rafaelchiafarelli/ArduinoIHM/IHM/initiatives/rs485_modbus/epics/uart3_driver/README.md

# Epic: uart3_driver

Interrupt-driven USART3 for RS-485 half-duplex.

## Tasks

```
1-usart3-rings-and-direction   RX ISR -> frame buffer + silence-timer re-arm, UDRE TX, TXC DE/RE release   (deps: can_bus event_timer/1; blocked: Q1, Q7)
```

## Acceptance gate

Build + native suite (ring tests); bench: loopback through the RS-485
module at 9600 and 115200 baud, with no lost bytes and the DE line
released within one character time after the last stop bit (scope).
