rafaelchiafarelli/ArduinoIHM/IHM/demo/HARDWARE_RUNBOOK.md

# Hardware runbook: PWM subsystem

Companion to `demo/demo_pwm_walkthrough.cpp`. That program proves the PWM
register math is correct by running the real production code against fake
registers on a PC. This runbook is the same checks, but on the real board,
where a bad COM-bit or a clobbered register would actually show up on a
scope/LED/motor instead of in a printed hex byte.

Requires: Arduino Mega 2560 flashed with this firmware, the display/rotary
encoder hardware wired per the schematic, and (for the PWM checks) an
oscilloscope or logic analyzer on the relevant pin -- a multimeter can
confirm duty cycle roughly via average DC voltage but won't show frequency
or edge polarity.

## Pin reference

| Channel | Timer  | Pin(s) | Notes |
|---|---|---|---|
| 0 | Timer3 | OC3A | simplex |
| 1 | Timer5 | OC5A | simplex -- OC5B/OC5C are claimed by the rotary encoders (PL4/PL5), so only OC5A is free |
| 2 | Timer1 | OC1A / OC1B / OC1C | complex, 3 outputs |
| 3 | Timer4 | OC4A / OC4B / OC4C | complex, 3 outputs |

Check your board variant's pinout diagram (`ELEC-MEGA2560-PINOUT.webp` in
the repo root) for which physical header pin each OCnX maps to.

## Driving PWM over MAVLink

The board accepts `PWM_CHANNEL_CONFIG` (id 303) on its protocol serial port,
Serial2 (D16/D17 through a USB-TTL adapter, 250000 baud, the same port as the
telemetry). The board's own USB port is debug-only. `COMx` below is the
adapter's port. Two ways to send it:

- **Companion app** (`IHMPCController`, PWM panel) -- see its `HOW_TO_USE.md`.
- **Script**: `python mavlink/scripts/pwm_config.py` (needs `pip install pymavlink`).

Prerequisites: board flashed with this firmware, USB-TTL adapter on Serial2,
nothing else holding the port (close the companion before using the script).

Duty is given in **percent** on the wire; the board scales it to the timer's
resolution. Frames with a bad channel (>3) or frequency selector are
silently dropped -- there is no ack, so probe the pin to confirm.

**Example A -- simplex channel 0 (OC3A), 62.5 kHz, 25 % duty**

    python mavlink/scripts/pwm_config.py --port COMx --channel 0 --freq 62500_HZ --a on --a-duty 25

Probe OC3A: 62.5 kHz square wave, 25 % high.

**Example B -- complex channel 2 (OC1A/OC1B), two outputs, different duties**

    python mavlink/scripts/pwm_config.py --port COMx --channel 2 --freq 3906_HZ --a on --a-duty 20 --b on --b-invert --b-duty 60

Probe OC1A (20 % high) and OC1B (inverting: 60 % duty means 40 % high) on a
shared 3.9 kHz timebase; OC1C stays disconnected.

See "Pin reference" above for the pins. This drives the same registers as
the on-screen PWM tab, so the two fight over a channel -- last writer wins,
the PWM tab mirrors PC-driven changes (enable, duty, state label showing the
frequency; complex channels' per-output *inverting* is not shown -- the UI has
no field for it) and repaints only while that tab is showing.

## UI navigation (src/main.cpp, lib/GUI/pwm.screen.yaml)

1. Power on. Rotate rot0 (encoder 0) to switch tabs (PWM / SERIAL / Output).
2. Rotate rot1 (encoder 1) to move the focus ring through the tab's
   controls: on the PWM tab, each channel's frequency label, its
   Enabled/Inverting (CH0/CH1) or A/B/C enable (CH2/CH3) switches, and every
   duty bar. The ring surrounds exactly the control rot2 will change.
3. Press rot1's button to activate the focused control: a switch flips; a
   frequency label steps to the next lower frequency (15 Hz wraps to
   62500 Hz); a duty bar does nothing.
4. Rotate rot2 (encoder 2) to change whatever is focused, live, with no
   confirm step:
   - frequency label: CW = higher, CCW = lower, stopping at 62500 Hz and
     15 Hz. Only the 13 fixed frequencies; VARIABLE (raw TOP) is PC-only.
   - duty bar: 1 % per detent, CW = higher, stopping at 0 and 100 %.
   - switch (PWM Enabled/Inverting, relay on the Output tab): CW = on /
     inverting, CCW = off / non-inverting. It sets, never flips: turning
     further the same way does nothing.

## Checks

### 1. Every fixed frequency actually appears (channels 0 and 1)

For channel 0 (or 1): cycle Mode to Fixed, then step Frequency through all
13 fixed entries. At each step, probe OC3A (or OC5A) and confirm the scope
shows the frequency printed in the demo log / on screen (e.g. `F:62500Hz`).
Pay particular attention to the 9-bit and 10-bit entries (frequencies
31250Hz, 15625Hz, 3906Hz, 1953Hz, 488Hz, 244Hz, 122Hz, 61Hz, 30Hz, 15Hz) --
these are exactly the cases where the pre-fix firmware produced no output
at all (missing COMnX1). If any of these show nothing on the scope, that's
a regression of the branch 2 fix.

### 2. Edge polarity (rising vs falling)

At any fixed frequency with duty cycle set away from 50% (so rising/falling
look visibly different), toggle the Edge field and confirm the scope shows
the duty-high portion moving from the start of the period (rising/
non-inverting) to the end (falling/inverting).

### 3. Duty cycle sweep

Step Duty Cycle from 0% to 100% and confirm the scope's measured duty cycle
tracks it. Check at least one 8-bit frequency (e.g. 62500Hz), one 9-bit
(31250Hz), one 10-bit (15625Hz), and Variable mode -- these each scale the
0-100% UI value against a different raw TOP (255/511/1023/your chosen
Variable Top), per `pwmResolutionTop()`.

### 4. Variable frequency mode

Cycle Mode to Variable, then adjust the Frequency field (now the raw TOP
register instead of a fixed-frequency list -- see the on-screen Hz readout,
computed as `16MHz / (TOP+1)`). Confirm the scope frequency matches the
on-screen readout at a couple of different TOP values.

### 5. Complex channel independence (channels 2 and 3)

With channel 2 (or 3) selected: enable output A at some duty cycle, probe
OC1A. Then, *without touching A's fields again*, enable output B at a
different duty cycle and inverted edge, and re-probe OC1A -- it must be
unchanged. Then enable output C and re-probe both OC1A and OC1B -- both
unchanged. This is the same sequence `runComplexIndependenceProof()` runs
against fake registers in the demo; on hardware it's the same proof against
a scope instead of a printed byte.

### 6. Mode field / Off state

For a simplex channel, cycle Mode to Off and confirm the pin goes idle
(steady low, no toggling) -- this is the case that used to have no explicit
"disabled" concept at all (see PWMChannelConfig's 3-way mode cycle).

## Out of scope for this pass

The relay outputs (`lib/MultiOutput/src/Relay.*`) and the serial command
protocol
(`lib/Comms/src/SerialCommunication.*`) are **not** exercised by this demo
or wired into the UI -- exactly as found in the original review, and
unchanged by any of the 5 branches in this pass (their scope was PWM
configuration, encoder/button input, and the Timer2 ISR setup only).
`MultiOutput::slow_handler()` runs from the tick already, but nothing
ever calls `Relay::enableRelay()` or feeds bytes into
`SerialCommunication::receive()`. (Servo and DC/stepper motor output were
items here originally -- `ServoMotor` was deleted 2026-08-16 and
`MotorDC` 2026-09-28, `fixes/000013`; neither is part of the IHM
solution now.) Wiring those into the UI (and, for serial,
fixing the unbounded `rcv_counter` growth in `receive()` noted in the
original review) is natural follow-up work, but doing it here would mean
demoing code nobody asked to have fixed yet.
