rafaelchiafarelli/ArduinoIHM/IHM/initiatives/rs485_modbus/epics/slave_register_map/tasks/3-bus-config-regs.md

# Task 3: bus-config-regs

**Status:** planned -- blocked on open question 6 (commit rule)
**Depends on:** task 2, `rs485_modes/1` (RS-485 settings), `serial_config`'s `config_model/1`

## Contract

1. The `SerialConfig` fields as holding registers: the generator fields
   (`serial_config`), the RS-485 settings (`rs485_modes/1`), and any CAN
   bus/protocol settings that exist by then (added by `can_bus`), each
   using its owner's validation.
2. The commit rule from open question 6, so a Modbus master can't cut
   its own link by accident.
3. Changes persist per `serial_config`'s save policy.
