rafaelchiafarelli/ArduinoIHM/IHM/initiatives/can_bus/epics/main_loop_timing/tasks/1-bound-the-loop.md

# Task 1: bound-the-loop

**Status:** planned (optional -- open question 4 answered: protocols are ISR-driven)
**Depends on:** nothing

## Contract

1. `app.yaml`
   `display.render_mode: non_blocking`, `main.cpp` calls
   `janus_render_poll()` each pass and uses the `*_async_start` calls;
   regen `lib/GUI` and re-vendor the companion.
2. Measure and record the worst-case loop period before and after.
3. Side effect to check: `IHM_UI_STATE` (308) no longer pauses during
   screen switches (the 1.97 s gap seen on 2026-09-27).
