rafaelchiafarelli/ArduinoIHM/IHM/initiatives/can_bus/epics/mcp2515_driver/tasks/3-tx-and-filters.md

# Task 3: tx-and-filters

**Status:** planned
**Depends on:** task 1

## Contract

1. Non-blocking TX through the 3 TX buffers (priority, "buffer full"
   returned, never waited on).
2. Acceptance masks/filters API (standard and extended).
3. Error state: TEC/REC, error-passive and bus-off readable, with
   recovery.
4. Native tests for the filter/mask encoding.
