rafaelchiafarelli/ArduinoIHM/IHM/initiatives/janus_handoff/2026-09-27-row-align-mirror-output.png

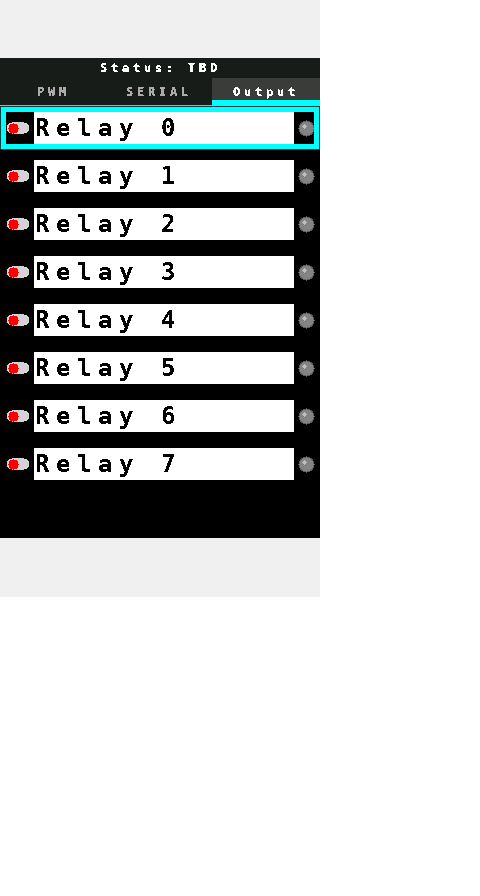
IHM/initiatives/janus_handoff/2026-09-27-row-align-mirror-output.png
