rafaelchiafarelli/ArduinoIHM/IHM/initiatives/janus_handoff/2026-09-27-row-align-mirror-pwm.png

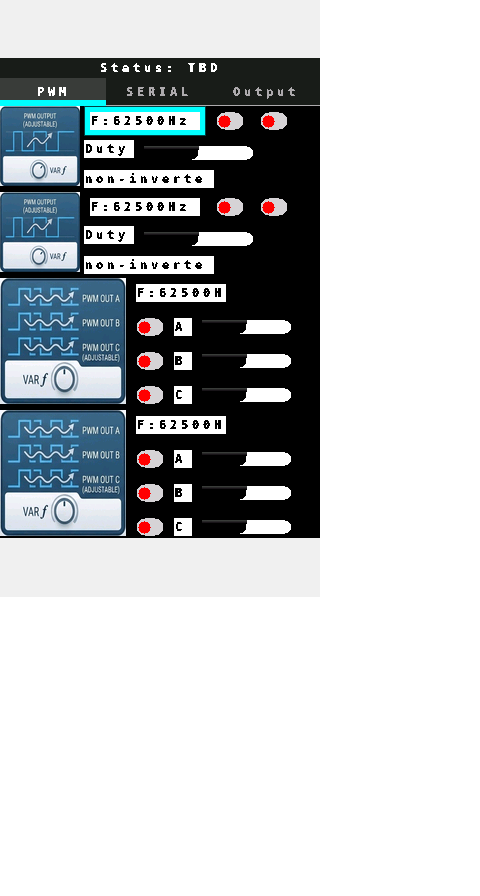
IHM/initiatives/janus_handoff/2026-09-27-row-align-mirror-pwm.png
