rafaelchiafarelli/ArduinoIHM/ElectricalProject/ArduinoIHM.kicad_pcb

## KiCad design ElectricalProject/ArduinoIHM.kicad_pcb (2026-01-17)

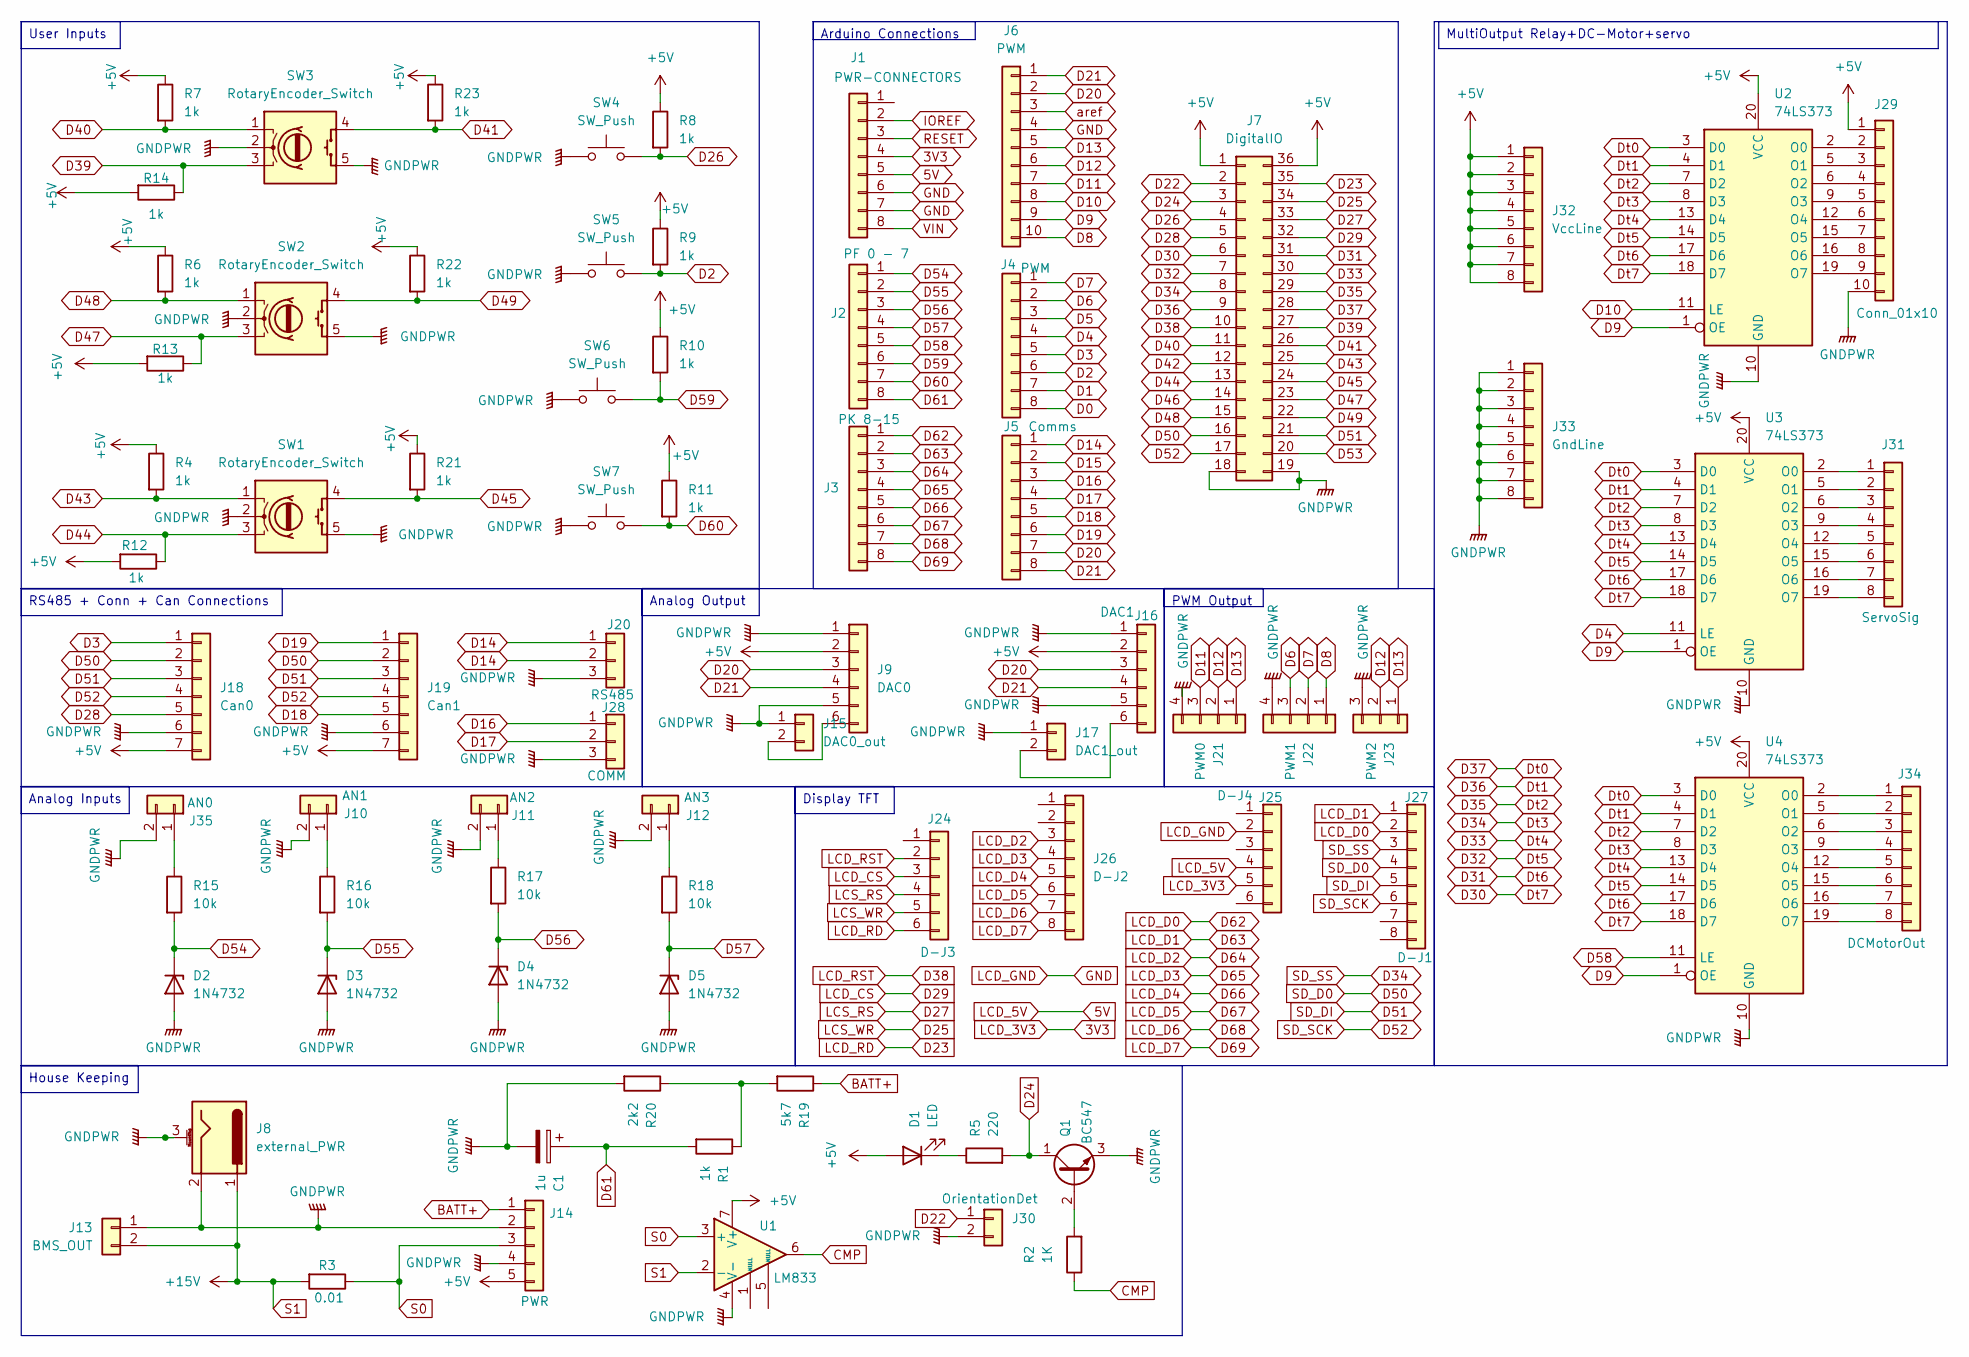
[picture p3: schematic ArduinoIHM.kicad_sch]

Parts:
C1: 1u; electrolytic capacitor
D1: LED; LED_D5.0mm
D2, D3, D4, D5: 1N4732; D_DO-41_SOD81_P10.16mm_Horizontal
J1: PWR-CONNECTORS; PinHeader_1x08_P2.54mm_Vertical
J2: PF 0 - 7; PinHeader_1x08_P2.54mm_Vertical
J3: PK 8-15; PinHeader_1x08_P2.54mm_Vertical
J4: PWM; PinHeader_1x08_P2.54mm_Vertical
J5: Comms; PinHeader_1x08_P2.54mm_Vertical
J6: PWM; PinHeader_1x10_P2.54mm_Vertical
J7: DigitalIO; PinHeader_2x18_P2.54mm_Vertical
J8: external_PWR; FanPinHeader_1x03_P2.54mm_Vertical
J9: DAC0; PinHeader_1x06_P2.54mm_Vertical
J10: AN1; PinHeader_1x02_P2.54mm_Vertical
J11: AN2; PinHeader_1x02_P2.54mm_Vertical
J12: AN3; PinHeader_1x02_P2.54mm_Vertical
J13: BMS_OUT; PinHeader_1x02_P2.54mm_Vertical
J14: PWR; PinHeader_1x05_P2.54mm_Vertical
J15: DAC0_out; PinHeader_1x02_P2.54mm_Vertical
J16: DAC1; PinHeader_1x06_P2.54mm_Vertical
J17: DAC1_out; PinHeader_1x02_P2.54mm_Vertical
J18: Can0; PinHeader_1x07_P2.54mm_Vertical
J19: Can1; PinHeader_1x07_P2.54mm_Vertical
J20: RS485; PinHeader_1x03_P2.54mm_Vertical
J21: PWM0; PinHeader_1x04_P2.54mm_Vertical
J22: PWM1; PinHeader_1x04_P2.54mm_Vertical
J23: PWM2; PinHeader_1x03_P2.54mm_Vertical
J24: D-J3; PinHeader_1x06_P2.54mm_Vertical
J25: D-J4; PinHeader_1x06_P2.54mm_Vertical
J26: D-J2; PinHeader_1x08_P2.54mm_Vertical
J27: D-J1; PinHeader_1x08_P2.54mm_Vertical
J28: COMM; PinHeader_1x03_P2.54mm_Vertical
J29: Conn_01x10; PinHeader_1x10_P2.54mm_Vertical
J30: OrientationDet; PinHeader_1x02_P2.54mm_Vertical
J31: ServoSig; PinHeader_1x08_P2.54mm_Vertical
J32: VccLine; PinHeader_1x08_P2.54mm_Vertical
J33: GndLine; PinHeader_1x08_P2.54mm_Vertical
J34: DCMotorOut; PinHeader_1x08_P2.54mm_Vertical
J35: AN0; PinHeader_1x02_P2.54mm_Vertical
Q1: BC547; TO-92_Inline
R1, R4, R6, R7, R8, R9, R10, R11, R12, R13, R14, R21, R22, R23: 1k; R_Axial_DIN0207_L6.3mm_D2.5mm_P5.08mm_Vertical
R2: 1K; R_Axial_DIN0207_L6.3mm_D2.5mm_P5.08mm_Vertical
R3: 0.01; R_Axial_DIN0207_L6.3mm_D2.5mm_P5.08mm_Vertical
R5: 220; R_Axial_DIN0207_L6.3mm_D2.5mm_P5.08mm_Vertical
R15, R16, R17, R18: 10k; R_Axial_DIN0207_L6.3mm_D2.5mm_P5.08mm_Vertical
R19: 5k7; R_Axial_DIN0207_L6.3mm_D2.5mm_P5.08mm_Vertical
R20: 2k2; R_Axial_DIN0207_L6.3mm_D2.5mm_P5.08mm_Vertical
SW1, SW2, SW3: RotaryEncoder_Switch; PinHeader_1x05_P2.54mm_Vertical
SW4, SW5, SW6, SW7: SW_Push; SW_PUSH_6mm_H4.3mm
U1: LM833; DIP-8_W7.62mm
U2, U3, U4: 74LS373; DIP-20_W7.62mm

Connections:
3V3: J1.4, J25.5
5V: J1.5, J25.4
+5V: D1.2 (A), J7.1, J7.36, J9.2, J14.5, J16.2, J18.7, J19.7, J29.1, J32.1, J32.2, J32.3, J32.4, J32.5, J32.6, J32.7, J32.8, R4.1, R6.1, R7.1, R8.1, R9.1, R10.1, R11.1, R12.2, R13.2, R14.2, R21.1, R22.1, R23.1, U1.7 (V+), U2.20 (VCC), U3.20 (VCC), U4.20 (VCC)
BATT+: J14.1, R19.1
CMP: R2.1, U1.6
D0: J4.8
D1: J4.7
D2: J4.6, R9.2, SW5.2
D3: J4.5, J18.1
D4: J4.4, U3.11 (LE)
D5: J4.3
D6: J4.2, J22.3
D7: J4.1, J22.2
D8: J6.10, J22.1
D9: J6.9, U2.1 (OE), U3.1 (OE), U4.1 (OE)
D10: J6.8, U2.11 (LE)
D11: J6.7, J21.3
D12: J6.6, J21.2, J23.2
D13: J6.5, J21.1, J23.1
D14: J5.1, J20.1, J20.2
D15: J5.2
D16: J5.3, J28.1
D17: J5.4, J28.2
D18: J5.5, J19.5
D19: J5.6, J19.1
D20: J5.7, J6.2, J9.3, J16.3
D21: J5.8, J6.1, J9.4, J16.4
D22: J7.2, J30.1
D23: J7.35, J24.6
D24: J7.3, Q1.1 (C), R5.2
D25: J7.34, J24.5
D26: J7.4, R8.2, SW4.2
D27: J7.33, J24.4
D28: J7.5, J18.5
D29: J7.32, J24.3
D30: J7.6, U2.18 (D7), U3.18 (D7), U4.18 (D7)
D31: J7.31, U2.17 (D6), U3.17 (D6), U4.17 (D6)
D32: J7.7, U2.14 (D5), U3.14 (D5), U4.14 (D5)
D33: J7.30, U2.13 (D4), U3.13 (D4), U4.13 (D4)
D34: J7.8, J27.3, U2.8 (D3), U3.8 (D3), U4.8 (D3)
D35: J7.29, U2.7 (D2), U3.7 (D2), U4.7 (D2)
D36: J7.9, U2.4 (D1), U3.4 (D1), U4.4 (D1)
D37: J7.28, U2.3 (D0), U3.3 (D0), U4.3 (D0)
D38: J7.10, J24.2
D39: J7.27, R14.1, SW3.3 (B)
D40: J7.11, R7.2, SW3.1 (A)
D41: J7.26, R23.2, SW3.4 (S1)
D42: J7.12
D43: J7.25, R4.2, SW1.1 (A)
D44: J7.13, R12.1, SW1.3 (B)
D45: J7.24, R21.2, SW1.4 (S1)
D46: J7.14
D47: J7.23, R13.1, SW2.3 (B)
D48: J7.15, R6.2, SW2.1 (A)
D49: J7.22, R22.2, SW2.4 (S1)
D50: J7.16, J18.2, J19.2, J27.4
D51: J7.21, J18.3, J19.3, J27.5
D52: J7.17, J18.4, J19.4, J27.6
D53: J7.20
D54: D2.1 (K), J2.1, R15.2
D55: D3.1 (K), J2.2, R16.2
D56: D4.1 (K), J2.3, R17.2
D57: D5.1 (K), J2.4, R18.2
D58: J2.5, U4.11 (LE)
D59: J2.6, R10.2, SW6.2
D60: J2.7, R11.2, SW7.2
D61: C1.1, J2.8, R1.2
D62: J3.1, J27.2
D63: J3.2, J27.1
D64: J3.3, J26.3
D65: J3.4, J26.4
D66: J3.5, J26.5
D67: J3.6, J26.6
D68: J3.7, J26.7
D69: J3.8, J26.8
GND: J1.6, J1.7, J6.4, J25.2
GNDPWR: C1.2, D2.2 (A), D3.2 (A), D4.2 (A), D5.2 (A), J7.18, J7.19, J8.2, J8.3 (MountPin), J9.1, J9.5, J10.2, J11.2, J12.2, J13.1, J14.2, J14.4, J15.1, J16.1, J16.5, J17.1, J18.6, J19.6, J20.3, J21.4, J22.4, J23.3, J28.3, J29.10, J30.2, J33.1, J33.2, J33.3, J33.4, J33.5, J33.6, J33.7, J33.8, J35.2, Q1.3 (E), R20.2, SW1.2 (C), SW1.5 (S2), SW2.2 (C), SW2.5 (S2), SW3.2 (C), SW3.5 (S2), SW4.1, SW5.1, SW6.1, SW7.1, U1.4 (V-), U2.10 (GND), U3.10 (GND), U4.10 (GND)
IOREF: J1.2
unnamed: D1.1 (K), R5.1
unnamed: J10.1, R16.1
unnamed: J11.1, R17.1
unnamed: J12.1, R18.1
unnamed: J9.6, J15.2
unnamed: J16.6, J17.2
unnamed: J29.2, U2.2 (O0)
unnamed: J29.3, U2.5 (O1)
unnamed: J29.4, U2.6 (O2)
unnamed: J29.5, U2.9 (O3)
unnamed: J29.6, U2.12 (O4)
unnamed: J29.7, U2.15 (O5)
unnamed: J29.8, U2.16 (O6)
unnamed: J29.9, U2.19 (O7)
unnamed: J31.1, U3.2 (O0)
unnamed: J31.2, U3.5 (O1)
unnamed: J31.3, U3.6 (O2)
unnamed: J31.4, U3.9 (O3)
unnamed: J31.5, U3.12 (O4)
unnamed: J31.6, U3.15 (O5)
unnamed: J31.7, U3.16 (O6)
unnamed: J31.8, U3.19 (O7)
unnamed: J34.1, U4.2 (O0)
unnamed: J34.2, U4.5 (O1)
unnamed: J34.3, U4.6 (O2)
unnamed: J34.4, U4.9 (O3)
unnamed: J34.5, U4.12 (O4)
unnamed: J34.6, U4.15 (O5)
unnamed: J34.7, U4.16 (O6)
unnamed: J34.8, U4.19 (O7)
unnamed: J35.1, R15.1
unnamed: Q1.2 (B), R2.2
unnamed: R1.1, R19.2, R20.1
RESET: J1.3
S0: J14.3, R3.1, U1.3 (+)
S1: J8.1, J13.2, R3.2, U1.2 (-)
VIN: J1.8
aref: J6.3

Notes on the sheet:
House Keeping
Arduino Connections
Analog Output
RS485 + Conn + Can Connections
Display TFT
Analog Inputs
MultiOutput Relay+DC-Motor+servo
User Inputs
PWM Output

Board: 2 copper layers, 76 parts (0 on the bottom side), 105 nets, no tracks yet.
