rafaelchiafarelli/ArduinoIHM/(commit log)

2025-11-12 moved Arduino library to the project
    [IHMDiagram.kicad_pcb, IHMDiagram.kicad_sch]
2025-11-19 adding files - first assembly
2025-11-30 adding tab configurations to pwm
2025-12-01 fixing pwm module to generate the outputs
2025-12-01 simplex and complex pwm configurations
2025-12-11 electrical project update
    [ArduinoIHM.kicad_sch]
2026-01-17 Electrical project update - fix page size
    [ArduinoIHM.kicad_pcb, ArduinoIHM.kicad_sch, IHMDiagram.kicad_pcb, IHMDiagram.kicad_sch]
2026-08-10 Fix and complete PWMStateMachine; add native unit test harness
    PWMStateMachine.h had a broken #include <events.h (unterminated,
    and events.h doesn't exist anywhere in the repo) and was otherwise
    a plain data-holder with no real transition logic -- it compiled
    only because nothing ever included it.
    - Fix the include, drop it entirely (no dependency was needed).
    - Add real channel selection (selectNextChannel/selectPreviousChannel,
    wrapping across the 4 PWM channels) and field-cursor cycling for
    both the simplex (PWM_0/PWM_1) and complex (PWM_2/PWM_3) channel
    UIs, plus isComplexChannel() so callers can tell which UI applies.
    - Trim SharedPWMStates: drop the D/E/F duty-cycle/edge/activat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
    [main.cpp, mini_test.h, test_pwm_state_machine.cpp]
2026-08-10 Fix PWM register bugs by consolidating into a tested pure core
    PWM.cpp's four setupPWMChannelN() functions were 1109 lines of
    hand-written, heavily copy-pasted register setup (14 frequency cases
    x up to 3 outputs x 4 timers), and every one of the following bugs
    appeared multiple times across that duplication:
    - Missing COMnX1 bit in every 9-bit and 10-bit mode (10 of 14
    frequency cases, in all four channels): the non-inverting branch
    set no COM bits at all (pin stays disconnected), and the inverting
    branch set only COMnX0 -- 0b01, which is a reserved bit combination
    for these Fast PWM widths on the ATmega2560, not "inverting". Both
    branches needed COMnX1 set; only COMnX0 should di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
    [test_pwm_config.cpp, test_pwm_timing.cpp]
2026-08-10 Restore ArduinoIHM.kicad_pcb footprint placement
    This was uncommitted work-in-progress (76 placed footprints) sitting
    in the working tree since around 2026-01-17, never committed. It was
    accidentally discarded by a git reset --hard run while working on an
    unrelated firmware branch; recovered from the KiCad backup zip
    ElectricalProject/ArduinoIHM-backups/ArduinoIHM-2026-01-17_143124.zip
    (still on disk, untracked), which matches the placement state
    observed earlier in the same session.
    No routing yet -- this is placement-only, same as before.
    [ArduinoIHM.kicad_pcb]
2026-08-11 Wire PWMScreen to real PWM hardware, with a live-editable config model
    Every value setupPWMChannelN() takes was previously either hardcoded
    or never called at all: PWMSimplex/PWMComplex only ever showed static
    placeholder text ("---%", "f:----------Hz", ...), and PWM pwm; in
    main.cpp was an unused object. There was no data model for "what is
    this channel currently configured to do" anywhere in the firmware.
    - PWMChannelConfig / PWMComplexChannelConfig (new): the UI-editable
    state for a channel -- enabled, frequency, duty cycle, edge -- plus
    pure mutation methods (cycle frequency, adjust duty %, toggle edge)
    and computeSimplexCallArgs()/computeComplexCallArgs(), which convert
    that st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
2026-08-11 Fix rot1's encoder/button pin swap; make ISR-shared globals volatile
    Each rotary encoder module occupies 3 consecutive BinaryInputs pin-table
    indices (two quadrature signal pins + one push button) -- encoder0 is
    6/7 with button 8, encoder2 is 12/13 with button 14. Encoder1 broke
    that pattern: RotaryEncoder.h wired its Pin1 to index 11 (PL0, its own
    push button) instead of 10 (PL1, its actual second signal pin), while
    main.cpp's rot1btn extraction read bit 10 instead of bit 11 -- the two
    pins had their roles swapped. Net effect: turning rot1 could look like
    pressing its button and vice versa, and rot1's rotation decode was
    reading its own button state as a quadrature signal.
    - RotaryEncoder.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
    [main.cpp, test_button_map.cpp, test_rotary_encoder.cpp]
2026-08-11 Only enable Timer2's Compare-A interrupt; drop the two empty ISRs
    setup() enabled all three of Timer2's interrupts (OCIE2A, OCIE2B,
    TOIE2) but main.cpp only ever defined a handler for Compare-A
    (TIMER2_COMPA_vect, the system tick). An AVR interrupt that's enabled
    and fires with no ISR defined vectors through avr-libc's default
    handler to __bad_interrupt, which jumps to the reset vector -- so
    Compare-B and Overflow firing here would have silently reset the MCU.
    The two empty ISR(TIMER2_COMPB_vect)/ISR(TIMER2_OVF_vect) definitions
    existed purely to intercept that ("must be defined here otherwise the
    system looses itself", per the comment that was there) rather than
    fixing the actual cause, whi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
    [Timer2Config.h, main.cpp, test_timer2_config.cpp]
2026-08-11 Add PWM outputs demo: host walkthrough + hardware runbook
    demo_pwm_walkthrough.cpp drives the real production code (the same
    PWMChannelConfig/PWMComplexChannelConfig edit methods, computeSimplex-
    CallArgs/computeComplexCallArgs, and applySimplexPWMConfig/
    applyComplexPWMConfig that PWMSimplex::editField/PWMComplex::editField
    call on-device) against fake registers, and prints the resulting
    TCCRxA/TCCRxB/OCRxA/B/C bytes for every channel x frequency x edge
    combination. It's not a pass/fail suite (test_native/ already covers
    that) -- it's a readable log a human can check the fixes against
    directly, e.g.:
    F:31250Hz edge=falling -> TCCRxA=0xC2 (9-bit inverting: both COM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
    [demo_pwm_walkthrough.cpp]
2026-08-11 Add changelog documenting today's PWM subsystem work
    Summarizes the branch stack (fix/pwm-state-machine through
    fix/timer2-isr-cleanup), the independent kicad_pcb restore branch, and
    this demo branch: what each fixes, test counts, and what's still out
    of scope. Meant to be read alongside the branches themselves when
    reviewing/merging the stack.
2026-08-12 Note Display-glue testing scope in handoff notes
    Investigated item 2 from the last handoff (native tests for PWM's
    Display-facing glue) before starting it. Element holds a concrete
    Display*, and Display/GFX.h chain into avr/io.h the same way
    SerialCommunication.h did -- testing it natively needs either a full
    Arduino/Display compatibility shim or a production-code interface
    refactor, not a quick test file. Recording that so it isn't
    re-discovered from scratch next time.
2026-08-12 Kill Display-glue native-test follow-up (won't fix)
    Decided not to pursue native tests for PWMSimplex/PWMComplex/GUI.cpp's
    Display-facing glue: the plan is to switch to an SPI display next
    hardware revision, which replaces the current parallel-TFT driver
    outright. Any test investment in today's Display/GFX glue would be
    thrown away, so it's not worth the compatibility-shim or
    interface-refactor effort scoped out on 2026-08-11.
2026-08-12 Wire Relay outputs into the UI (Output tab)
    First of the three not-wired-in output types (relay/servo/motor) from
    the 2026-08-10 follow-ups -- scoped to Relay only. Follows the same
    pattern already proven for PWM: a pure/testable RelayConfig, thin
    Display-facing RelayElement/RelayScreen glue, then GUI wiring. rot1
    rotates through the 8 relays on the Output tab, its button toggles
    the highlighted one live.
    Confirmed pin safety first: Relay uses BinaryOutputs indices 0-7
    exclusively, no overlap with MotorDC (8-13) or ServoMotor (8-17) --
    those two overlap each other, a pre-existing issue left untouched.
    MultiOutput now exposes getRelays() so GUI drives the same Relay
    instance MultiOutput::slo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
    [main.cpp, test_relay_config.cpp]
2026-08-12 Add architecture documentation; discover multiplexed output bus
    Full documentation pass: ARCHITECTURE.md, a README in every lib/ module
    and src/, and a drawio diagram covering the module map, scheduling
    model, and known gaps.
    While investigating a suspected Timer4 register conflict between PWM
    channel 3 and a planned ServoMotor wiring, cross-checking against the
    user's IOs IHM.xlsx and KiCad schematic revealed that Relay/ServoMotor/
    MotorDC don't drive independent GPIO pins at all -- they share one 8-bit
    bus behind three 74LS373 latches, addressed by per-device strobe lines
    (dig_0/dig_1/dig_2). BinaryOutputs::SetOutput() doesn't implement this
    protocol, so Relay's existing UI wiring likely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
    [ArduinoIHM.kicad_sch, IOs IHM.xlsx]
2026-08-12 Sync IOs IHM.xlsx (v0) pin plan with ArduinoIHM.kicad_sch
    Relabeled global_label pin numbers across the encoder/output-bus
    region to match the "v0" sheet's new plan, and fixed a leftover
    LCD_RST label that was still on D38 (shorted against rotary
    encoder 2's channel-A switch) instead of its new D31 assignment.
    Note: this is the last commit before the IO change.
    [ArduinoIHM.kicad_sch, IOs IHM.xlsx]
2026-08-12 Add MAVLink telemetry/command protocol and analog-input driver
    New IHM_BOARD_STATE/CAN_SIGNAL_CONFIG/RS485_SIGNAL_CONFIG dialect
    (IHM/mavlink/), wired into main.cpp's superloop: board pushes user-input +
    analog telemetry roughly every 100ms, and parses incoming CAN/RS-485
    signal-generator commands (stored only -- no bus driver exists yet to act
    on them). Replaces the redundant raw Serial.print() debug lines, which
    would otherwise have corrupted the binary MAVLink stream on the same UART.
    Also new: a register-direct ADC driver (lib/AnalogInput) for the 4 analog
    inputs + BattVoltage, none of which were read anywhere in this codebase
    before. Flagged as a known gap (ARCHITECTURE.md item 9): it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
    [main.cpp]
2026-08-14 Write the multiplexed-output-bus driver; fix Relay's write sequence
    MultiplexedBus (lib/MultiOutput/src/MultiplexedBus.h) implements the
    settle-bus -> raise-strobe -> drop-strobe protocol Relay/ServoMotor/
    MotorDC's three 74LS373 latches need, on top of BinaryOutputs::SetOutput(),
    wrapped in ATOMIC_BLOCK so ServoMotor's future ISR-context writes can't
    race Relay/MotorDC's foreground writes. enableOutputs() drives OUTPUT_EN
    low once at setup, confirmed active-low against the KiCad schematic.
    Relay rewired to use it (assembles all 8 relays into one byte, one
    write() call) instead of the old one-SetOutput()-per-relay model.
    ServoMotor/MotorDC untouched -- still blocked on their own bit-layout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
2026-08-14 Ignore committed backup zips going forward
    ElectricalProject/ArduinoIHM-backups/*.zip was being tracked by
    accident; a git filter-repo history rewrite already stripped the 18
    existing zips out of dev's history in this session. This just stops
    new ones from getting added the same way.
2026-08-14 Delete confirmed-dead code: StateMachine, SPITFT/GrayOLED, Stream's timeout methods
    Cleared out dead code found while writing the multiplexed-bus driver and
    while investigating a while(millis()) loop the user flagged in Stream.cpp.
    - lib/StateMachine/StateMachine.hpp/.cpp: didn't compile, unreferenced.
    PWMStateMachine.h (actually used) is untouched.
    - lib/Display/SPITFT.cpp/.h, SPITFT_Macros.h, GrayOLED.cpp/.h: vendored,
    confirmed nothing else included them.
    - Stream's millis()-based timeout/parsing methods (timedRead, readBytes,
    parseInt, find, etc.): zero callers outside ArduinoLib, confirmed by
    grep before deleting. Stream.h now only declares the pure-virtual
    available()/read()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
    [main.cpp]
2026-08-14 Note: connected board is an old hw revision, flash doesn't mean verified
    Uploaded this session's firmware (with the new MultiplexedBus driver) to
    a Mega 2560 clone on COM7 -- upload succeeded and verified, but the user
    confirmed the physical hardware connected is an old revision, not the
    board the multiplexed-bus/74LS373-latch model was derived from. A
    successful flash isn't the same as a hardware test; the "unverified
    against a physical board" caveat throughout the docs still stands.
2026-08-15 Simplify the on-board TFT UI; build a real SERIAL/bus-status screen
    Element's virtual-by-value setter pattern is gone entirely (grepped: nothing
    ever used polymorphism through it, so de-virtualized rather than just fixed
    the return type), duplicated Label/LED blink-counter logic factored into a
    shared BlinkAnimator (fixing a mis-ordered blink-speed bug along the way),
    magic-number button masks and tab-layout constants named/composed properly,
    and confirmed-dead GUI code (ScreenType/currentWork, six unwired methods)
    deleted.
    The previously-placeholder SERIAL tab is now a real read-only monitor
    (BusStatusScreen) of the CAN0/CAN1/RS-485 signal-generator config the board
    receives from the new P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
    [main.cpp]
2026-08-15 Add UI-rotation planning notes and a current-state render-pipeline diagram
    Portrait/landscape support (housekeeping pin, live switching, non-blocking
    incremental redraw) was scoped in conversation but deliberately not
    designed yet -- ui-rotation.md captures the requirements, constraints, and
    open questions (notably the bit-to-4-angles mapping) for a fresh session to
    pick up. docs/gui-render-pipeline.drawio is a focused diagram of how a
    frame currently gets drawn and where the rotation bit currently goes,
    built to reason about where the new scheduler should plug in -- descriptive
    only, not a proposed design.
2026-08-15 Record UI-rotation scope findings and shelve the feature
    Second-pass assessment found the pin is a pulse (not absolute-position,
    resolving the 4-angle mapping question) but surfaced bigger blockers:
    no edge detection/debounce exists for it yet, the existing MAVLink
    rotation field is already reading it wrong, RAM headroom is tight, and
    widgets hold position as an implicit truth that a live rotation breaks
    (BlinkAnimator erase-by-remembered-rect). Shelved pending those answers.
2026-08-16 Rewrite MotorDC onto the multiplexed bus, wire its tick handler
    MotorDC predated the multiplexed-bus finding and still used raw
    BinaryOutputs indices that collide with PWM's pins and the bus's own
    strobe/OUTPUT_EN lines. Rewritten to go through MultiplexedBus like
    Relay, with coarse software-PWM speed control on the existing ~1ms
    system tick (no dedicated fast timer is free -- Timer1/3/4/5 are fully
    committed to PWM's 4-channel generator). MultiOutput::fast_handler() is
    now actually called from TIMER2_COMPA_vect. Bit layout within MotorDC's
    latched byte is a placeholder pending schematic confirmation.
    [main.cpp]
2026-08-16 Delete ServoMotor: servo control is not part of the IHM solution
    ServoMotor::timer_handler() wrote directly to OCR4A (owned by PWM
    channel 3, actively used) -- same landmine pattern MotorDC had, plus a
    stale pin-index model and a clamp bug. Deeper problem: servos need real
    pulse-width resolution, and like MotorDC there's no dedicated fast timer
    free (Timer1/3/4/5 are fully committed to PWM's 4-channel generator) --
    but unlike MotorDC's coarse on/off duty cycling, servo position control
    can't get away with the existing ~1ms tick's resolution.
    User's call: kill servo support entirely rather than solve that timing
    problem here. A separate, dedicated servo controller is planned for the
    future,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
    [main.cpp]
2026-08-16 Make AnalogInputs::read() non-blocking via an interrupt-driven ADC scan
    read() used to block on a while(ADCSRA & (1<<ADSC)) polling loop --
    ~104-520us across all 5 channels every ~100ms, the same class of problem
    as a delay() call under this project's no-blocking-waits rule.
    AnalogInputs::setup() now starts a free-running round-robin conversion;
    a new ISR(ADC_vect) in main.cpp (calling AnalogInputs::isr_handler())
    caches each completed conversion and immediately triggers the next
    channel, forever. read() just returns the cached value -- non-blocking,
    and fresher than before as a side effect (bounded by one ~1ms scan cycle
    instead of the caller's ~100ms read cadence). Follows the project's
    e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
    [main.cpp]
2026-08-19 Clear content area on tab switch in GUI
    show() only marks elements dirty for the next update() redraw; it never
    clears anything, and no screen's elements cover the full content rect,
    so switching tabs left stale pixels behind. Clear the rect before
    show() on both CCW/CW branches, and drop the switch's unreachable
    default case that used to (wrongly) handle this with a WHITE clear.
2026-08-23 Replace hand-written TFT UI with Janus-generated code; fix AVR PROGMEM bugs
    lib/Elements and the old lib/GUI/GUI.cpp/.h are gone, replaced by UI
    generated by Janus from lib/GUI/*.screen.yaml/app.yaml, plus its
    hand-written runtime (janus_runtime.c/.h, janus_font.*,
    janus_input_focus.*). This migration itself predates this commit; this
    is its first hardware bring-up and first time landing in git.
    First boot hung/rendered garbage due to two AVR PROGMEM bugs in Janus's
    fixed runtime library: janus_app_t.screens is an array of pointers
    living in flash, and every generated janus_screen_desc_t instance is
    itself flash-resident, but both were read with plain indexing/-> access
    instead of pgm_read_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
    [main.cpp]
2026-08-23 Reorganize Janus runtime into include/src; reapply box-collapse clear fix
    Janus regenerated lib/GUI into the standard PlatformIO include/+src/
    layout (previously flat) and picked up the two AVR PROGMEM fixes from
    handle-to-janus.md upstream: janus_widget_load()/janus_screen_load() are
    now clean static inline, by-value accessors in janus_runtime.h, with a
    doc comment describing the exact flash-read pattern that doc reported.
    New janus_input_touch.*/janus_input_encoder.h/janus_input_buttons.h
    also came in with this regeneration (unused by this project so far).
    The regeneration did not carry over janus_toggle_box()'s stale-pixel
    fix (never reported upstream, only ever a local fix) -- a collaps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
    [main.cpp]
2026-09-05 Redesign PWM tab around Janus's new box.summary drawers; adopt janus_render_widget for the header refresh
    PWM screen rebuilt for the real 320x480 panel (was hand-tuned for a
    placeholder 320x240) around collapsible "drawer" boxes -- one per
    channel, header always shows mode icon/LED/state/frequency/duty via
    Janus's new box.summary primitive, body (Enabled/Inverting toggles, now
    actually wired to on_press) only visible when expanded. New status-bar +
    tab-bar block at the top (tab-bar buttons navigate between screens, with
    this screen's own tab given a brighter background) -- first instance of
    a pattern meant to repeat on SERIAL/Output once those get the same pass.
    Frequency labels are static p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
    [janus_actions.cpp, main.cpp]
2026-09-07 feat(PWM): unify complex-channel Mode cycle with simplex; add PWM tab channel icons
    PWMComplexChannelConfig gains a channel-level `enabled` gate and the same
    three-way Off -> Fixed -> Variable Mode cycle as PWMChannelConfig --
    mode()/cycleModeNext()/cycleModePrevious() replace the old two-way
    toggleMode(). computeComplexCallArgs forces every output's enable low
    while the channel is gated off; the shared timer keeps running.
    pwm.screen.yaml adds an enabled + hidden "disabled" icon image per
    channel row. platformio.ini lists lib/GUI/runtime as its own lib_deps
    entry so the Janus runtime's sources compile and link. Regenerated
    pwm_screen.gen.c; +77 native tests for the new Mode cycle.
    [demo_pwm_walkthrough.cpp, main.cpp, test_pwm_channel_config.cpp]
2026-09-07 docs: align architecture docs with the Janus-generated UI; prune stale content
    ARCHITECTURE.md gains a "The UI is generated (lib/GUI)" section (Janus
    generator vs. vendored runtime vs. firmware glue, the input/render/action
    ownership split, a "where a UI bug lives" table); the module map and ASCII
    diagram now show the Janus flow instead of the deleted GUI::update() /
    Elements path. src/README.md's foreground-work paragraph updated the same
    way.
    Removed historical narrative and references to code no longer in the tree
    across all three docs: ServoMotor, lib/Elements, the struck-through
    "Known gaps" entries for already-fixed/deleted items, RAM-percentage
    snapshots, dated "fixed on <date>" note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
2026-09-07 chore: add IHM-workflow Claude skill
    Encodes the initiative -> epic -> task planning hierarchy, the matching
    git branch ancestry and --no-ff merge chain, the per-task implementation
    loop, and the stop-and-flag rules for parallel-session work.
2026-09-07 docs(serial_commands): scope the PC-serial-control initiative
    First initiative-structured effort in this repo. Establishes the
    initiatives/ tree and the serial_commands branch. Transport is the
    existing MAVLink dialect on the debug Serial port; MavlinkComms stays
    storage-only, main.cpp drives hardware. First epic: pwm_control.
2026-09-07 docs(pwm_control): plan the PWM-over-MAVLink epic
    Epic README + 5 task files with contracts, dependency graph, and DoD:
    1 dialect message + regen (no deps)
    2 pure config->args mapping+test (no deps)
    3 MavlinkComms decode + main.cpp apply to timers + runbook (deps 1,2)
    4 pymavlink bench sender (deps 1)
    5 mirror onto the on-screen PWM tab (deps 3)
    Unified single message PWM_CHANNEL_CONFIG (id 303) keyed by channel,
    covering both simplex and complex channels. MavlinkComms stays
    storage-only; main.cpp owns the hardware apply.
2026-09-16 regen(GUI): vendor Janus runtime @ ae95e13 — nav_tabs task 4, ui_widgets epic
    Catches lib/GUI/runtime up with Janus's current main (73 commits ahead of
    the last vendor sync, 968d339): nav_tabs task 4 folds the tab strip into
    encoder/button focus traversal (janus_focus_move/activate now take
    janus_app_t*, not a screen), and the ui_widgets epic lands real bar/switch/
    disc rendering plus a new `vu` kind, draw_primitives, and label_format
    (janus_draw.h/.c, janus_format.h/.c, janus_bound.h/.c are new files this
    pulls in). Also fixes a real bug found this session: a focused headerless
    box's full-body ring never erased when focus moved to another widget,
    since draw_box_header paints nothing at al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
2026-09-16 fix(GUI): align PWM/BusStatus/Relay on one shared top structure
    All three screens now render identically top-to-bottom: Janus's
    auto-generated nav strip, then a status_bar row, then screen content —
    found inconsistent while bringing up the regenerated UI on real hardware:
    - pwm.screen.yaml: dropped the hand-authored tab_bar row (PWM/SERIAL/
    Output buttons with `navigate:` targets) — a manual tab switcher built
    before app.yaml's `nav: { kind: tabs }` strip existed. Now that Janus
    renders that same strip automatically above every screen, the row was
    a leftover duplicate showing up above/below the real one.
    - relay.screen.yaml: had two top-level `children:` keys (left over from
    a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
2026-09-16 fix(main): catch up to Janus's new focus API; fix two real render bugs
    janus_focus_move/janus_focus_activate now take janus_app_t* instead of a
    screen pointer (nav_tabs epic task 4, so a single control can fold the
    tab strip into focus traversal) — updates all 5 call sites, otherwise a
    hard compile error against the freshly-vendored runtime.
    Two real bugs found bringing this up on real hardware, both fixed here:
    - setup() never called janus_render_nav_bar(), so the PWM/SERIAL/Output
    strip stayed blank at cold boot — it only ever got painted once the
    first janus_switch_screen() ran (rot0 turned). Added the missing call,
    matching Janus's own reference scaffold.
    - the ~100ms telemetr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
    [main.cpp]
2026-09-16 docs(janus_handoff): hand off two Janus runtime issues found this session
    Documentation-only, no ArduinoIHM code contract — follows the precedent
    handle-to-janus.md (repo root) set on 2026-08-23. Two items for a session
    working directly in the Janus checkout: the headerless-box focus-ring fix
    already applied there (uncommitted, needs review/commit in that repo) and
    a scoped-but-unbuilt feature request (status bar rendered above the nav
    strip, currently impossible since Stage 2 hardcodes the nav band at y=0).
2026-09-19 docs(relay_control): plan the relay-state-telemetry epic
    Scopes this first epic pass to board -> PC relay telemetry only
    (IHM_RELAY_STATE), not PC -> board control -- motivated by the PC
    controller app needing a truthful relay indicator, not a new command
    path.
2026-09-19 feat(mavlink): add IHM_RELAY_STATE message
    Board -> PC telemetry, id 304: a 1-byte bitmask of all 8 relay outputs,
    mirroring main.cpp's relayState[] the same way IHM_BOARD_STATE.buttons
    mirrors the button bitmap. Sent on the same ~100ms cadence as
    sendBoardState(). Read-only for now -- no PC -> board relay command
    exists yet (see the epic README).
    platformio run (megaatmega2560) builds; test_native/run_tests.ps1
    passes (101 cases).
2026-09-19 docs(input_simulation): plan the encoder-simulation epic
    Scopes this first pass to simulated encoder CW/CCW only (what was
    actually requested) -- simulated button presses reuse the same wire
    pattern and are a follow-up task, not built here.
2026-09-19 feat(mavlink): add IHM_SIMULATE_ENCODER message
    PC -> board, id 305: injects one simulated CW/CCW rotation step on a
    given encoder (0-2). Applied only when that encoder's real hardware
    read was idle the same superloop pass -- real input always wins, and
    the injected value is consumed exactly once, mirroring
    RotaryEncoder::getDirection()'s own edge-triggered semantics. Nothing
    downstream of dir[] changes: a simulated turn drives rot0/rot1
    navigation and shows up in IHM_BOARD_STATE telemetry exactly like a
    real one.
    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
2026-09-19 docs(serial_commands): reflect relay_control and input_simulation epics
    The initiative README's epics table was never updated when
    relay_control was planned last session -- it still listed relay_control
    as "not yet scoped" after that epic's first task had already landed.
    Corrects that and adds input_simulation, plus broadens the initiative's
    one-line pitch to cover simulated inputs, not just output control.
2026-09-20 fix(main): render Janus app-level status bar; drop dead per-screen status refresh; note non-blocking serial requirement
    [main.cpp]
2026-09-20 feat(mavlink): PWM_CHANNEL_CONFIG message (id 303) + PWM_FREQUENCY enum
    Task 1 of serial_commands/pwm_control. Dialect, regenerated C headers and
    mavlink/README.md message table; task file marked done.
2026-09-20 docs(serial_commands): plan serial_transport + pc_companion epics; correct pwm_control tasks 2/3
    - New epic serial_transport: Timer2-tick bounded RX drain + drop-not-block TX
    (Rafael's main.cpp notes).
    - pwm_control: setupPWMChannelN takes RAW OCR duty, not percent; reuse
    computeSimplex/ComplexCallArgs. Task 2 renamed scope to a wire adapter
    (PWMWireConfig) -- the old PwmChannelConfig name collided with
    PWMChannelConfig.h on case-insensitive filesystems.
    - New epic pc_companion for the Windows companion app.
2026-09-20 feat(serial): bounded Timer2-tick MAVLink RX (MavlinkComms::tick), atomic take* accessors
    Replaces the unbounded superloop poll(). ISR cost is bounded by
    MAVLINK_RX_BYTES_PER_TICK and NOT bench-measured yet. Build: RAM 4214 B
    (unchanged), Flash +194 B. Native tests 101/101. Task file marked done.
    [main.cpp]
2026-09-20 feat(pwm): PWMWireConfig adapter from wire message to PWMChannelConfig types
    Reuses computeSimplex/ComplexCallArgs for percent->raw scaling. 9 new native
    tests (110/110 pass). Task file marked done.
2026-09-20 feat(pwm): apply PWM_CHANNEL_CONFIG from MAVLink to the PWM timers
    MavlinkComms stores + atomic take; main.cpp validates, scales via
    compute*CallArgs and calls setupPWMChannelN. RAM 4347 B (53.1%, +132 B),
    Flash +1.7 kB. Runbook section added. Bench waveform check is Rafael's.
2026-09-20 feat(mavlink): generate a Python dialect binding; pwm_config.py bench sender
    generate.py now emits generated/ (C) and generated_py/ (Python). Verified
    a Python-encoded PWM_CHANNEL_CONFIG frame decodes with the firmware's C
    headers. Task file marked done.
2026-09-20 feat(ui): reflect MAVLink PWM configs on the PWM tab
    Mirrors into pwm_instance + dirty bits, frequency into the state label via
    formatFrequencyLabel (RAM buffer), repaints only dirty widgets and only when
    the PWM tab is active. RAM 4467 B (54.5%), Flash 70842 B (27.9%). Task file
    marked done.
2026-09-20 revert(serial): undo serial_transport epic; Serial0 is debug-only
    Reverts cbe890c (Timer2-tick MAVLink RX) and 00e68d0 (drop-not-block TX).
    They assumed MAVLink lives on the debug Serial port; it must instead move to
    a different hardware serial (e.g. Serial2). poll()/serial->write() restored;
    PWM take accessor kept (non-atomic, superloop-only). Notes added to
    ARCHITECTURE, NEXT-SESSION, CHANGELOG, mavlink README, epic README and
    main.cpp. AVR build OK (RAM 54.5%), native tests 110/110.
    [main.cpp]
2026-09-20 feat(mavlink): IHM_SIMULATE_BUTTON so the PC can press buttons; sim_input.py
    One-pass press pulse OR-ed into btnMap after buildButtonMap(); real input
    wins. Encoder injection already existed. AVR build OK (RAM 54.7%).
2026-09-22 regen(GUI): pick up Janus desktop_windows_mirror — MSVC-safe build, janus_remote API
    Ran janus-generate against lib/GUI/app.yaml on Janus main @ 064229e
    (desktop_windows_mirror epic). Embedded-side effects only (the desktop
    target's own output lives outside this repo, in IHMPCController):
    - CMakeLists.txt: -Wall -Wextra now gated off MSVC (JANUS_WARN_FLAGS)
    - New runtime/{include,src}/janus_remote.c(.h) + tests/test_remote.c:
    janus_remote_state_get/apply, the mirror-mode API from this session's
    janus_handoff request (2026-09-20-desktop-windows-and-mirror.md) —
    device-side snapshot / viewer-side apply of {screen, focus, nav_focus,
    boxes_expanded}, redraw-only, fires no actions/na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
2026-09-22 docs(pwm_state_telemetry): defect record — no board->PC PWM state readback
    PWM_CHANNEL_CONFIG (303, PC->board) has no counterpart; IHM_RELAY_STATE
    (304) gives relays real telemetry, PWM has none, so the companion app's
    "no ack -- check the output pin" is the honest truth, not a bug. Records
    the gap as a not-yet-scheduled initiative (Rafael: "I will fix it
    later") -- one epic (pwm_state_message), one task, mirroring
    relay_control's shape. Docs only, no code changes.
2026-09-22 docs(workflow-skill): add Defect vocabulary + container-collision rule
    New Vocabulary entry: a Defect is a gap/bug found incidentally, recorded
    as a normal-shaped initiative (record now, work later) rather than
    worked immediately. New Branches-section paragraph covers the case this
    session hit live: epics/tasks names already taken by an active chain in
    the same clone -- resolution is to skip those container branches for a
    Defect, commit its initiative folder straight on the <initiative>
    branch, and merge directly to features; create the real containers only
    once implementation starts. Docs only.
2026-09-24 docs(serial_transport): re-plan epic for MAVLink on Serial2, interrupt-driven
    Tasks 3 (lib/Uart2: ByteRing + USART2 ISRs) and 4 (MavlinkComms on Uart2,
    fast_handler from Timer2, atomic copy-outs, drop-not-block TX). Tasks 1-2
    (Serial0 attempt) marked superseded.
2026-09-24 feat(uart2): interrupt-driven USART2 driver with SPSC ring buffers
    lib/Uart2: own USART2_RX_vect/USART2_UDRE_vect that only move bytes
    between UDR2 and ByteRing<64> rings; all-or-nothing writeFrame (drop, never
    block, never a partial frame); saturating rx-drop/line-error/tx-drop
    counters. ByteRing is header-only and natively tested (7 new cases,
    117/117 pass). Not yet called by firmware (task 4). AVR build OK, RAM
    unchanged at 54.7% since nothing links it yet.
    [test_byte_ring.cpp]
2026-09-24 feat(mavlink): move MAVLink to Serial2, interrupt-driven RX/TX
    MavlinkComms now rides lib/Uart2 (own USART2 ISRs + rings) instead of
    HardwareSerial on the debug port. poll() is replaced by fast_handler(),
    called last in TIMER2_COMPA_vect with interrupts re-enabled (busy-flag
    guarded) and bounded to MAVLINK_RX_BYTES_PER_TICK=32. Superloop accessors
    are ATOMIC_BLOCK copy-outs; CAN/RS-485 getters copy out instead of
    returning pointers. TX packs in the superloop and enqueues whole frames or
    drops (drop-not-block). Baud stays 250000 (MAVLINK_SERIAL_BAUD); scripts
    now take the USB-TTL adapter's port.
    AVR build: RAM 4477 -> 4611 B (54.7% -> 56.3%), Flash 70694 -> 71260 B.
    Native tests 117/117. Not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
    [main.cpp]
2026-09-24 chore(build): drop vendored lib/ArduinoLib, use stock framework = arduino
    The copy was the only Arduino core the build used (platformio.ini had no
    framework line). Now framework = arduino supplies it. Four locally edited
    files (HardwareSerial0.cpp, Stream.h, wiring.c, Wire.cpp) are dropped
    unreviewed, at Rafael's request. RAM 4611 -> 4619 B, Flash 71260 -> 71284 B.
    Native tests 117/117.
2026-09-25 docs(navigation): plan navigation initiative -- input enumeration, RE0 drill-down, B0 back, 4 s timeout
    Three epics (input_map, nav_state_machine, value_editing), eight task
    files. Six open questions recorded in the initiative README, each
    blocking the task it names.
2026-09-25 feat(GUI): focus_ring on relay rows and PWM toggle rows
    Opts each relay row and each PWM toggle row (Enabled / Inverting / A / B /
    C) into Janus's row focus ring (janus fixes/000005): whichever toggle has
    focus, the cyan ring goes around its whole row. YAML only -- lib/GUI is
    NOT regenerated. Takes effect on the next regen with a Janus that has
    focus_ring (janus dev @ 36adb5a+). Each ringed row grows 12px (6px inset
    per side); with janus dev, app.yaml's nav: also turns on the nav strip,
    which together push PWM to 500px of 480 -- resolve at regen time.
2026-09-26 docs(serial_transport): plan task 6 -- preemptible Timer2 tick (RX overrun fix)
2026-09-26 fix(serial): make the Timer2 tick preemptible so USART2 RX never overruns
    The tick kept interrupts off for up to ~216 us before re-enabling them
    for the MAVLink parser only; at 250000 baud USART2 overruns after ~120 us,
    losing ~60 % of PC -> board frames on the bench. sei() is now the ISR's
    first statement and the busy flag is gone (the tick must fit its ~1 ms
    slot). Bench: 10/10 presses applied, 0 bad frames in a 10 s stream.
    [main.cpp]
2026-09-26 docs(serial_commands): record bench results, button-sim and companion tasks, epic statuses
2026-09-26 fix(GUI): drop stale PWM frequency placeholder labels
    Each PWM row showed a fixed pwm_chN_freq label beside the live
    chN_state_label, so every channel displayed a second, wrong frequency.
2026-09-26 feat(GUI): simplify PWM CH0/CH1 rows -- no switches, duty bar under frequency, inverted/non-inverted text
    Janus regenerated as a black box from the yaml change; main.cpp fills the
    new chN_inverting_label string binding (RAM strings, non-inverted at boot).
    [main.cpp]
2026-09-26 feat(GUI): PWM CH0/CH1 switches beside the frequency; black canvas; RE1 scans the screen only
    - CH0/CH1 Enabled/Inverting toggles, unlabeled, each in its own
    focus_ring row (Janus toggles draw no ring of their own)
    - app.yaml display.background #000000 and black bg on SERIAL's boxes:
    tab switches, ring erases and box unfocus painted white before
    - RE1 focus wraps within the active screen (nav-less app copy)
    Janus regenerated as a black box; bench-checked on the board.
    [main.cpp]
2026-09-26 feat(pwm,GUI): PWM switches drive the timers; green/red LEDs; relay LEDs
    - pbRE1 on a focused PWM switch flips that output's enable/inverting bit
    and re-applies the channel (applyPwmChannel, shared with
    PWM_CHANNEL_CONFIG). Boot default per channel: 62500 Hz, 50 %, off.
    - LEDs green on / red off (PWM CH0/CH1, SERIAL); new LEDs beside the
    CH2/CH3 A/B/C switches; relay rows end in an LED, green on / grey off.
    - Relay presses mirror into relay_instance so the Relay tab follows.
    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
    [janus_actions.cpp, main.cpp]
2026-09-26 feat(uart2): default TX ring 64 -> 128
    Each ~100 ms telemetry tick is about to queue IHM_BOARD_STATE (31 B) +
    IHM_RELAY_STATE (13 B) + IHM_PWM_STATE (25 B) = 69 B, and writeFrame()
    drops whole frames that don't fit. 128 is ByteRing's maximum.
2026-09-26 feat(mavlink): add IHM_PWM_STATE message (id 307)
    Board -> PC readback of the config applied to one PWM channel, same fields
    as PWM_CHANNEL_CONFIG so the PC can compare sent vs. applied. Regenerated
    C + Python bindings; README messages table, TX budget, ring size.
2026-09-26 feat(pwm): send IHM_PWM_STATE round-robin from the telemetry tick
    MavlinkComms::sendPwmState() packs it; main.cpp sends one channel per
    ~100 ms tick from pwmLast[] (duty clamped to 100 as applied), so all four
    refresh every ~400 ms. Closes the pwm_state_telemetry defect; the task file
    records the as-built decisions and the companion-app changes (not under git).
2026-09-26 feat(pwm): pwmStepFrequency / pwmCycleFrequency for on-screen editing
    Pure, host-tested stepping over the 13 fixed PWMFrequency selectors:
    step is clamped (no wrap), cycle wraps 15 Hz -> 62500 Hz, and neither
    ever produces frequency_variable (raw TOP stays PC-only).
    [test_pwm_timing.cpp]
2026-09-26 feat(GUI,pwm): edit PWM frequency on screen -- RE1 focuses, RE2 steps, pbRE1 cycles
    Each channel's frequency label is now a focusable focus_ring row with
    on_press: cycle_pwm_chN_frequency (regenerated with Janus dev 36adb5a).
    With it focused, RE2 steps the frequency live (CW = higher, clamped) and
    pbRE1 cycles it one lower, wrapping; both re-apply the channel through
    applyPwmChannel, so the tab and IHM_PWM_STATE follow. Runbook's UI
    section rewritten for the current controls; navigation initiative notes
    the new RE2 role where it assumed RE2 unused.
2026-09-26 docs(initiatives): value_editing/3 split into delivered vs. remaining; PWM readback acceptance passed
    value_editing/3 now records what fixes/000006 already shipped (stepping
    logic, apply path, focusable labels, temporary RE2 shortcut) and what's
    left for the RE0 edit level, including the RE2 keep/remove decision. Its
    dependency moves from value_editing/2 to nav_state_machine/3 (the apply
    path exists since fixes/000004). pwm_state_message's acceptance check
    passed on COM3.
2026-09-26 feat(GUI,pwm): RE2 changes the selected duty bar, 1 % per detent
    Every PWM duty bar is selectable (own focus_ring row, no-op
    edit_pwm_*_duty press action); CH2/CH3's A/B/C lines split into a switch
    ring and a bar ring so the ring shows exactly what RE2 changes. RE2 steps
    the focused bar through pwmStepDuty (clamped 0-100, unit-tested) and
    re-applies via applyPwmChannel, so the tab and IHM_PWM_STATE follow.
    Regenerated with Janus dev 36adb5a. Completes navigation value_editing/2.
2026-09-27 docs(pc_companion): record encoder hold-to-repeat (task 4)
    IHMPCController isn't under git; this task file is the record. CCW/CW
    repeat one IHM_SIMULATE_ENCODER every 200 ms while held; B0-B3/Push
    deliberately don't repeat.
2026-09-27 fix(encoder): no phantom step from the first sample after boot
    RotaryEncoder's last-state bits started at the constructor's 0/0, a state
    the pins were never read in. An encoder resting with one line high (10 or
    01) therefore decoded a CW/CCW step on the first ms_handler() at every
    power-up -- on the bench board RE1 CCW + RE2 CW, which moved focus to the
    last widget and nudged CH3 C's duty to 51 %. The first sample now only
    seeds the last state (primed flag). 3 new native tests; 125 pass.
    [test_rotary_encoder.cpp]
2026-09-27 fix(input): a button held at power-up is not a press
    prevBtnMap started at 0xFF (nothing held), so any button already down on
    the first superloop pass fired a click. The bench board's pbRE1 reads
    held at rest (IHM_BOARD_STATE buttons = 0x53: pbRE1, B2, B3 low), so every
    boot pressed the focused widget once -- after the encoder fix that became
    CH0's frequency label, stepping it 62500 -> 31250 Hz. Seed prevBtnMap from
    the first real read. Verified on the board over 3 resets: clean defaults,
    focus on CH0's frequency label, one RE2 step = one change.
    [main.cpp]
2026-09-27 docs(navigation): re-plan value_editing/1 -- RE2 sets switches (CW on, CCW off), relays too
2026-09-27 feat(pwm,relay): RE2 sets the selected switch -- CW on/inverting, CCW off/non-inverting
    janusSetSwitch() resolves any toggle_* action (10 PWM switches, 8 relays)
    and sets it rather than flipping it; asking for the current state is a
    no-op. PWM goes through pwmWireSetOutputBit (pure, 4 new tests) +
    applyPwmChannel; relays share a new setRelay() with the press path.
    Bench DoD 8/8 over COM3. Completes navigation value_editing/1.
    [janus_actions.cpp, main.cpp, test_pwm_wire_config.cpp]
2026-09-27 fix(GUI): switches and their LEDs repaint as RE2 turns
    janus_render_screen_if_dirty clears a field's dirty flag at the first
    widget bound to it, so of each switch+LED pair only one repainted (CH0/CH1
    switches stayed stale until focus moved). Full janus_render_screen after
    an RE2 switch change, like the pbRE1 press path. Root cause handed to Janus
    (initiatives/janus_handoff/2026-09-26-dirty-flag-shared-field.md).
    [main.cpp]
2026-09-27 regen(GUI): janus dev @ c56f14c -- every widget bound to a dirty field repaints
    Picks up janus shared_field_dirty (the handoff from
    initiatives/janus_handoff/2026-09-26-dirty-flag-shared-field.md):
    janus_render_screen_if_dirty now tests dirty flags during the sweep and
    clears them after it, so an LED and the toggle bound to the same field
    (PWM CH0-3, relays) both repaint. Only the vendored runtime changes
    (janus_runtime.{h,c} + its tests); generated screens and the lib/GUI
    scaffolds are byte-identical. janus_render_widget_if_dirty is now
    deprecated upstream; nothing in IHM calls it.
    Not done here: the full janus_render_screen() workaround after an RE2
    switch change (b04ee2b) lives on the na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
2026-09-27 regen(GUI): Janus shared_field_dirty -- drop the full-redraw workaround
    lib/GUI/runtime regenerated from Janus dev c56f14c: janus_render_screen_if_dirty
    now repaints every widget bound to a changed field (flags tested in one
    pass, cleared in a second). RE2 switch changes go back to the dirty-only
    repaint; the PC_CHANNEL_CONFIG path's switch+LED pairs are fixed by the
    same regen. Handoff note marked resolved.
    [main.cpp]
2026-09-27 docs(pc_companion): plan task 5 -- frequency and duty sliders
    VARIABLE is set in Hz on a log slider (244 Hz - 8 MHz) instead of raw TOP;
    duty becomes per-output sliders that snap to what the board can produce at
    the selected frequency. Companion only.
2026-09-27 docs(pc_companion): record task 5 done -- frequency and duty sliders
    IHMPCController isn't under git; this is the record. VARIABLE is set with a
    log slider in Hz (TOP computed), duty with per-output sliders snapping to
    what the board can produce; Outputs/result lines show Hz. Bench on COM3
    via the real UI: 5 slider positions read back the expected TOP.
2026-09-27 fix(GUI): CH0/CH1 frequency label fits 11 characters; "Duty:" caption
    The CH0/CH1 frequency label was 9 characters wide, so VARIABLE frequencies
    above 99 999 Hz (the companion slider now reaches 8 MHz) were cut off.
    Widened 90 -> 110 px, and a static "Duty:" caption added in front of the
    CH0/CH1 duty bars. CH2/CH3 unchanged. Regenerated with Janus dev c56f14c.
    Recorded as navigation value_editing/4.
2026-09-27 docs(desktop_mirror): plan the companion screen mirror -- mirror_transport + companion_mirror epics
    Uses Janus desktop_windows_mirror (janus_remote get/apply). Decisions from
    Rafael 2026-09-27: embedded in the placeholder via a companion GDI driver,
    bound values mapped from existing telemetry, one new UI-state message.
2026-09-27 feat(mavlink): IHM_UI_STATE (308) -- Janus remote UI state, board -> PC
    janus_remote_state_t as four scalars; MavlinkComms::sendUiState packs it.
    Native round-trip test; mavlink/generated on the native include path.
2026-09-27 feat(mirror): board sends IHM_UI_STATE on change and every 500 ms
    janus_remote_state_get(&janus_app) in the ~100 ms telemetry tick.
    Flash +584 B, RAM +18 B.
2026-09-27 docs(companion_mirror): task 1 -- desktop UI vendored at Janus c56f14c; MSVC gate result for Janus
    MSVC builds with and without the SDL driver; 2 runtime tests fail only
    because the app's janus_render_config.gen.h overrides their -D fixtures.
2026-09-27 docs(companion_mirror): task 2 -- GDI Janus driver; mirror renders in its own column
2026-09-27 docs(companion_mirror): task 3 -- PWM/relay telemetry fills the mirror's bindings
2026-09-27 docs(companion_mirror): task 4 -- mirror follows IHM_UI_STATE; no-board overlay
2026-09-27 docs(companion_mirror): task 5 partial bench on the old board -- mirror tracks the board; 308 gap during redraws
2026-09-27 docs(janus_handoff): toggle knob colours -- light-gray track, red off / green on knob
    The switch look is a bug (fixes/00000b); Janus's toggle knob is a fixed tint
    of the track, so the fix needs an authorable knob colour first.
2026-09-27 fix(GUI): switches draw a gray track with a red (off) / green (on) knob
    Uses janus's new toggle keys knob_off / knob_on (janus dev 125eef4,
    fixes/000007/toggle-knob-colors) on all 18 toggles -- 10 on the PWM tab,
    8 relays: bg = color = #D0D0D0 (one light-gray track in both states),
    knob_off #FF0000, knob_on #00FF00. The gray can be tuned on the TFT.
    lib/GUI regenerated with that janus: the two screens + the vendored
    runtime (knob fields, draw_toggle).
    Verified: avr-gcc -mmcu=atmega2560 compiles lib/GUI clean; host render of
    PWM + Output shows red-left / green-right knobs on a gray track. Vendored
    runtime ctest: same 2 pre-existing failures as before (display.background
    assumption in janus's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
2026-09-27 docs(janus_handoff): toggle colours done -- board flashed, companion mirror re-vendored at Janus 125eef4
2026-09-27 fix(GUI): drop the 8 PWM LEDs -- each repeated the Enabled switch beside it
    CH0/CH1 enable LED and CH2/CH3 A/B/C LEDs removed from pwm.screen.yaml;
    lib/GUI regenerated (janus 125eef4). pwm_t field order follows first use,
    so ch0/ch1_enabled moved below the state label (names unchanged).
    Flash 76906 B; 132 native tests pass.
2026-09-27 docs(janus_handoff): row cross-axis align -- relay rows and PWM A/B/C letters misaligned
    Rows top-align every child; centering needs an authored row option first
    (fixes/00000d, blocked on Janus).
2026-09-27 fix(GUI): centre relay rows and PWM A/B/C rows vertically
    Uses janus's new row option align: center (janus dev fcc4ed3,
    fixes/000008/row-cross-axis-align) on the 8 relay rows (switch and LED
    now centred on the 32px label, inside the focus-ring inset) and on the 6
    CH2/CH3 A/B/C rows (the letter now level with its switch and duty bar,
    no longer 6px above them). lib/GUI regenerated with that janus: only the
    two screens change (layout is build-time; the runtime is unchanged).
    PWM + Output shows the rows centred.
    Not done: flashing + the check on the real TFT, and re-vendoring the PC
    companion's include/ from the same jan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
2026-09-27 docs(janus_handoff): row align done -- board flashed, companion mirror updated at Janus fcc4ed3
2026-09-27 fix(GUI): CH2/CH3 A/B/C rows no longer drift down past the picture
    Rows were 34 px apart (18 px switch + 12 px ring inset + 4 px gap) next to
    PWM OUT lines ~24 px apart, and the 132 px column overran the 126 px
    picture (CH3 ended at y 484 on a 480 px panel). Switches now 24x12 (relay
    size) and duty bars 12 px tall, so each A/B/C row is 24 px at a 28 px
    pitch; the channel row centres the 114 px column on the picture
    (align: center). Freq label stays on top (Rafael's choice).
2026-09-27 fix(GUI): duty-cycle percentage label left of every PWM duty bar
    text "%d%%" labels bound to the same chN[_x]_duty_percent field as the
    bar (8: CH0/CH1 after the "Duty:" caption, CH2/CH3 after the A/B/C
    letter). CH2/CH3 bars 90 -> 64 px to fit; CH0/CH1 duty rows centred
    (align: center) so caption, % and bar share one line.
2026-09-27 fix(GUI): SERIAL tab -- one compact row per bus instead of three stretched boxes
    CAN0/CAN1/RS-485 were fill:true boxes (a third of the panel each) with
    unlabelled value placeholders. Now three align:center rows at the top:
    LED, name, captioned values via label format templates (ID %x, DLC %d,
    EXT %d, LEN %d, %d ms). Same bus_status bindings; widest row ends at x 317.
    Editing is the serial_config initiative.
2026-09-27 docs(serial_config): plan SERIAL tab configuration -- model, wire, board editing, companion panel
    Rafael 2026-09-27: compact row per bus, edit on board + companion,
    generator + bus params + protocol mode + EEPROM. Six open questions
    recorded against the tasks they block. Pointer on navigation Q5.
2026-09-27 docs(can_bus): plan the CAN foundation -- SPI sharing, MCP2515 driver, generator, loop timing, SD
    Hardware facts from IOs IHM.xlsx (two SPI CAN modules, SD on the same
    SPI), J1939 / UDS / CANopen feasibility and limits recorded; protocol
    epics wait for open question 5. Seven open questions.
2026-09-27 docs(rs485_modbus): plan Modbus RTU slave on RS-485 -- USART3 driver, RTU framing, register map, modes
    Rafael 2026-09-27: slave first; exposes telemetry, relays, PWM and bus
    config; RS-485 runs one mode at a time (off / raw generator / Modbus).
    Proposes answering from the Timer2 tick like MAVLink so replies don't
    stall on screen redraws. Seven open questions. Pointers in serial_config.
2026-09-27 fix(tick): MAVLink fast handler is the first call after sei() in the Timer2 ISR
    It ran last, after the input/output handlers and the 25 ms block. Rafael's
    rule (2026-09-27): always first after sei(), nothing in between. Its only
    consumers are superloop take/consume/get copy-outs, so no in-tick order
    dependency. Rule recorded in main.cpp, ARCHITECTURE.md and src/README.md.
    [main.cpp]
2026-09-27 docs(can_bus): strictly event-driven -- event_timer epic, INT-driven MCP2515 I/O, generator on timer expiries
    Rafael 2026-09-27: no polling in the serial part (MAVLink exempt). New
    event_timer epic (one-shot compare + software queue), shared with
    rs485_modbus. Open question 4 answered; new Q8 (which free timer).
2026-09-27 docs(rs485_modbus): strictly event-driven -- RX ISR re-arms silence timer, expiry answers, TXC releases DE
    Rafael 2026-09-27: no polling in the serial part (MAVLink exempt). Drops
    the Timer2-tick proposal; depends on can_bus's event_timer. Open question
    2 answered; ISR budget remains.
2026-09-27 fix(nav): screen switches never leave focus on the tab strip
    Since fixes/000010 SERIAL has no focusable widget, so the rot0 switch's
    janus_focus_move(&janus_app, 0) put focus on the nav strip, and
    janus_switch_screen doesn't clear the strip's preview: later screens then
    had widget AND strip focus (IHM_UI_STATE focus 0 + nav_focus 1; the mirror
    drew the ring on the strip). New focusFirstOnScreen(): clear the strip
    preview, then focus with the strip-less app copy rot1 already uses. Used
    at boot, on rot0 and on a navigate action.
    [main.cpp]
2026-09-27 docs(navigation): close the initiative -- today's controls are final; input_map and nav_state_machine dropped
    Rafael, 2026-09-27: the PWM tab as it works now is the standard. RE0 cycles
    tabs, RE1 walks the tab's selectables and wraps, RE2 edits the focused
    control live, pbRE1 keeps its press. No drill-down, no pbRE0/B0 role, no
    inactivity timeout.
    - navigation README rewritten to the final controls and closing decisions
    (open questions 1, 2, 5, 6, 7 closed).
    - input_map (2 tasks) and nav_state_machine (3 tasks) marked dropped,
    never built; plans kept as a record.
    - value_editing/3 done: fixes/000006 already delivered it; the navigator
    follow-up is moot, the frequency labels keep on_pr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
2026-09-27 docs(pwm_state_telemetry): remove the done initiative's folder
    Task 1 (IHM_PWM_STATE, id 307) shipped as fixes/000005/pwm-state-telemetry
    and is in dev; the epic's acceptance gate passed 2026-09-26. Git history
    keeps the record.
2026-09-27 docs(serial_commands): plan PC -> board relay commands -- relay_control/2 + pc_companion/6
    Rafael, 2026-09-27: IHM_RELAY_COMMAND (id 309) as mask + state; companion
    gets 8 relay checkboxes that send on click and follow IHM_RELAY_STATE.
2026-09-27 feat(mavlink): IHM_RELAY_COMMAND (309) -- PC switches relays, mask + state
    - Dialect: IHM_RELAY_COMMAND { mask, state }; relays with a mask bit are
    set to their state bit, others untouched. Sets, never flips. No ack --
    IHM_RELAY_STATE (304) is the readback. Regenerated C + Python bindings.
    - RelayCommand.h (lib/MavlinkComms/src, pure): relayCommandAccumulate folds
    frames that arrive before the superloop takes them; relayCommandApply is
    the rule main.cpp applies. 6 native tests.
    - MavlinkComms: dispatch accumulates, takeRelayCommand copies out
    atomically. Still no relay dependency (layering rule).
    - main.cpp/janus_actions.cpp: setRelay exported as relaySet and shared with
    the Outp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
    [janus_actions.cpp, main.cpp, test_relay_command.cpp]
2026-09-27 docs(pc_companion): task 6 -- relay switches in the companion, bench-verified
    IHMPCController (not under git; .relay-switches.bak beside each edited
    file): dialect re-synced with 309, SendRelayCommand, 8 R0-R7 checkboxes
    that send IHM_RELAY_COMMAND on click and follow IHM_RELAY_STATE,
    HOW_TO_USE.md. Builds x64 + x86 Debug. Bench on COM3: companion clicks
    switch relay 0 both ways; board-side RE2 changes move the tick.
2026-09-27 docs(serial_commands): close and remove the initiative -- every epic done
    serial_transport, pwm_control, input_simulation, pc_companion and
    relay_control are done and bench-verified (relay commands landed today:
    IHM_RELAY_COMMAND 309 + companion switches). Git history keeps the plan.
    - The initiative's layering rule for MavlinkComms moves to
    mavlink/README.md; serial_config and mirror_transport now point there.
    - NEXT-SESSION: motor_control and dac_control (never scoped, each blocked
    on a hardware fact) become open items; the relay on-screen check is
    recorded as owed; the companion's record-keeping rule no longer names
    this initiative.
    - README links mavlink/README.md instead of the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
2026-09-27 docs(companion_mirror): task 5 done -- old board counts, TFT match confirmed, 308 gap handed to non_blocking_redraw
    Rafael, 2026-09-27: the old board revision counts for the cross-epic gate;
    mirror == TFT and no flicker confirmed by eye. Re-measured the heartbeat
    gap on dev: a switch to the PWM tab stalls IHM_UI_STATE 1.85 s (two turns:
    1.97 / 2.38 s), past the 1.5 s overlay timeout. Fix is the blocking redraw
    itself, in a new initiative, not a longer timeout.
2026-09-27 docs(desktop_mirror): close and remove the initiative -- both epics done
    mirror_transport (IHM_UI_STATE 308, sent on change + 500 ms heartbeat) and
    companion_mirror (GDI mirror in IHMPCController, tasks 1-5) are done; the
    cross-epic gate closed on the old board by Rafael's decision. Git history
    keeps the plan and the bench screenshots. The heartbeat stall during
    full-screen redraws goes to the new non_blocking_redraw initiative
    (NEXT-SESSION updated).
2026-09-27 docs(non_blocking_redraw): plan the initiative + Janus handoff for a bounded non-blocking render
    Rafael, 2026-09-27: fix the blocking full-screen redraw (1.85 s on a PWM
    tab switch) at its cause; target no superloop pass blocked > 20 ms by
    rendering; Janus handoff now, no profiling first; ui-rotation stays
    shelved but gets a pointer.
    - Janus's existing render_mode: non_blocking doesn't fit (6912 B queue vs
    ~3.3 KB free, 256-op cap, blocking clear/bars) -- requirements handed to
    Janus in janus_handoff/2026-09-27-bounded-nonblocking-render.md.
    - Epics: loop_timing (max-pass-time instrument, unblocked but for open
    question 1), janus_render (regen, waits on Janus), superloop_render
    (bud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
2026-09-28 docs(serial_config): shrink to the shared framework; bus settings move to their owners
    Hybrid ownership (Rafael, 2026-09-27): serial_config owns the SerialConfig
    container, the append-only EEPROM image, the SERIAL tab editing mechanics
    and row layout rule, the wire pattern and the companion panel, and ships
    the generator settings only. CAN bitrate goes to can_bus, RS-485 mode /
    baud / format / Modbus address to rs485_modbus, protocol settings to the
    protocol epics. Adds the extension contract and open question 7 (how
    extension settings travel on the wire). serial_config is implemented first.
2026-09-28 docs(rs485_modbus): own the RS-485 settings as a serial_config extension
    New rs485_modes/1-settings adds mode, baud, format and slave address to
    serial_config's framework (model, EEPROM, wire, screen, companion); the
    mode switch becomes rs485_modes/2. Adds open questions 8 (combined format
    field vs parity + stop bits) and 9 (write protect, response delay, status
    display).
2026-09-28 docs(can_bus): own the CAN bitrate and protocol settings as serial_config extensions
    New mcp2515_driver/4-bitrate-setting adds the per-bus bitrate to
    serial_config's framework and applies it on change; protocol mode and
    protocol settings go to each protocol epic's own settings task. The
    generator reads SerialConfig (serial_config lands first). Adds open
    question 9 (bitrate values, default, listen-only).
2026-09-28 docs(serial_config): record Rafael's answers to all 7 open questions
    Two rows per bus, every value its own RE1-focusable field edited by RE2;
    digit-at-a-time RE2 acceleration; the enable switch saves the whole
    config; boot loads and uses the saved config; 10 ms period units; last
    writer wins; generic IHM_SERIAL_SETTING key/value pair for extensions
    (ids 311-314, 310 left for non_blocking_redraw).
2026-09-28 feat(bus-config): SerialConfig model, RE2 step helpers, digit acceleration, 301/302 adapters
    New lib/BusConfig: the SERIAL tab's settings, one section per bus with the
    signal generator only (serial_config's framework; bus initiatives extend
    it per lib/BusConfig/README.md). Range checks match 301/302, EXT off
    clamps the ID, step helpers clamp or wrap, and DigitAccel implements the
    digit-at-a-time RE2 acceleration (4 fast clicks up one digit, 300 ms pause
    down one, 1.5 s reset). 18 new native tests.
    [test_serial_config.cpp]
2026-09-28 feat(mavlink): SERIAL readbacks (311/312) and the generic setting pair (313/314)
    IHM_CAN_SIGNAL_STATE / IHM_RS485_SIGNAL_STATE mirror 301/302 as the
    board's readback (as 307 mirrors 303). IHM_SERIAL_SETTING (bus, key,
    int32 value) and IHM_SERIAL_SETTING_STATE (+ status) are the generic path
    for settings bus initiatives add to SerialConfig; the key table in
    mavlink/README.md starts empty. 310 is left for non_blocking_redraw's
    proposed IHM_LOOP_STATS. README: message table, key table, TX budget.
2026-09-28 feat(serial): apply 301/302 to a live SerialConfig; 311/312 readback; answer 313
    MavlinkComms now hands 301/302 out as pending take* slots (was a
    latest-value get) and queues IHM_SERIAL_SETTING (4 deep, each answered).
    main.cpp keeps the SERIAL tab's settings in a SerialConfig: 301/302 are
    validated (canGeneratorFromWire / rs485GeneratorFromWire) and applied on
    arrival, mirrored to bus_status_instance with dirty flags and repainted
    if the tab is showing -- which also fixes the tab only refreshing on a
    tab switch. One bus's IHM_CAN_SIGNAL_STATE / IHM_RS485_SIGNAL_STATE goes
    out ~50 ms into each window (the TX ring can't hold it behind the
    telemetry burst). Every 313 is answered "unknown key"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
    [main.cpp]
2026-09-28 feat(gui): editable SERIAL tab -- two rows per bus, every value a focusable field
    bus_status.screen.yaml: enable switch, ID, DLC / LEN on row 1; EXT,
    period, repeat, byte index and byte value on row 2, each in a focus_ring
    row with an on_press action (serial_config question 1). CAN ID and period
    bind as int64, repeat as a string ("x inf"). The row rule for bus
    initiatives is in the yaml header. lib/GUI regenerated (Janus fcc4ed3);
    mirrorSerialToUi() fills the new fields. The companion's vendored
    include/ is regenerated from the same run.
2026-09-28 feat(serial): RE2 edits the SERIAL tab with digit-at-a-time acceleration
    SerialEdit (lib/BusConfig, host-tested) applies one RE2 click to a
    (bus, field): switches are set (CW = on), numbers step by unit x the
    digit acceleration within their range, the byte index picks the data
    byte the value field edits and follows DLC/LEN. main.cpp maps the focused
    action to its field and resets the acceleration on a new field; pbRE1 on
    an enable switch flips it. mirrorSerialToUi() marks only changed fields
    dirty so a click repaints one label. 12 new native tests.
    [janus_actions.cpp, main.cpp, test_serial_edit.cpp]
2026-09-28 feat(serial): load SerialConfig from EEPROM at boot; save when an enable switch toggles
    setup() loads the saved config and uses it as saved (serial_config
    question 4). Toggling any bus's enable switch -- pbRE1 or RE2 on the
    board, or a 301/302 that changes enable -- saves the whole config
    (question 3); other edits stay in RAM until then.
2026-09-28 docs(companion): mirror's SERIAL tab from 311/312 (record)
    MirrorBindings maps IHM_CAN_SIGNAL_STATE / IHM_RS485_SIGNAL_STATE into
    bus_status like the firmware's mirrorSerialToUi(); boot values follow
    serialConfigDefaults. The board's B<n> byte selection isn't reported, so
    the mirror shows byte 0. MirrorBindingsTest covers it (all checks pass).
2026-09-28 docs(serial_config): record the bench pass -- all four epics verified on the board
    Flashed the old board revision (COM7) and checked over MAVLink on COM3:
    readbacks, 301 apply/drop, 313 answer, simulated knob editing with
    acceleration, and EEPROM persistence across a reset. The companion's
    SERIAL panel was driven headlessly against the board. Not checked: the
    mirror's SERIAL tab by pixel and the knob feel by hand.
2026-09-29 docs(serial_config): close and remove the initiative -- all four epics done
    config_model (lib/BusConfig: SerialConfig, EEPROM image, RE2 editing and
    acceleration), wire (311-314), board_editing (editable SERIAL tab, save
    on enable toggle, load at boot) and companion_panel (IHMPCController
    SERIAL panel + mirror) are done and bench-verified 2026-09-28. Git
    history keeps the plan; the extension recipe lives in
    lib/BusConfig/README.md, the row rule in bus_status.screen.yaml, the key
    table in mavlink/README.md. NEXT-SESSION: the SERIAL passive-refresh gap
    is gone; the hand-feel and mirror checks are listed as owed.
2026-09-29 docs(can_bus): repoint serial_config references after its close
    The extension recipe now lives in lib/BusConfig/README.md, the row rule
    in bus_status.screen.yaml, the wire path in mavlink/README.md's key
    table. "Applied on leaving the field" was a proposal serial_config did
    not adopt, so when a bitrate change takes effect joins open question 9.
2026-09-29 fix(outputs): remove DC/stepper motor control -- the motor was never connected
    MotorDC was constructed in stepper mode and re-latched a stepper sequence
    onto the unused motor latch every ~1 ms Timer2 tick. Deleted MotorDC.h/
    .cpp, MultiOutput::fast_handler() and its tick call; the motor latch
    (dig_2, MUX_MOTOR_STROBE) stays wired and MultiOutput::setup() latches 0
    into it once. Its outputs are freed for rs485_modbus's RS-485 DE/RE line
    (Rafael, 2026-09-28). Done as a fix branch at Rafael's request; no
    initiative task covered motor work (motor_control was never scoped).
    Docs updated; NEXT-SESSION drops motor_control and the bit-layout item.
    RAM 62.4 % -> 62.2 %.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
    [main.cpp]
2026-09-29 fix(relays): restore the relays at power-up as they were at power-off
    Every relay change -- on-screen, RE2 or IHM_RELAY_COMMAND -- is recorded
    in EEPROM once per superloop pass, and setup() restores the last mask
    (all off on a blank EEPROM). Rafael, 2026-09-28: record every change.
    To make that affordable the mask goes into a 32-slot wear-levelled ring
    at EEPROM 256-351 ([mask, ~mask, seq], ~3.2M changes per cell budget,
    torn writes fall back to the previous state); RelayStore is pure and
    host-tested (6 tests). Done as a fix branch at Rafael's request.
    [main.cpp, test_relay_store.cpp]
2026-09-30 feat(dac): DAC outputs back, driven by IHM_DAC_COMMAND, Wire timeout instead of the bypass
    A missing DAC now fails its write (reported in IHM_DAC_STATE) instead of
    hanging setup() in twi.c. Both DACs start at code 0.
    [main.cpp]
